RavuAlHemio/dcf77-faker/board/dcf77_faker.kicad_pcb

## KiCad design board/dcf77_faker.kicad_pcb (2023-04-06)

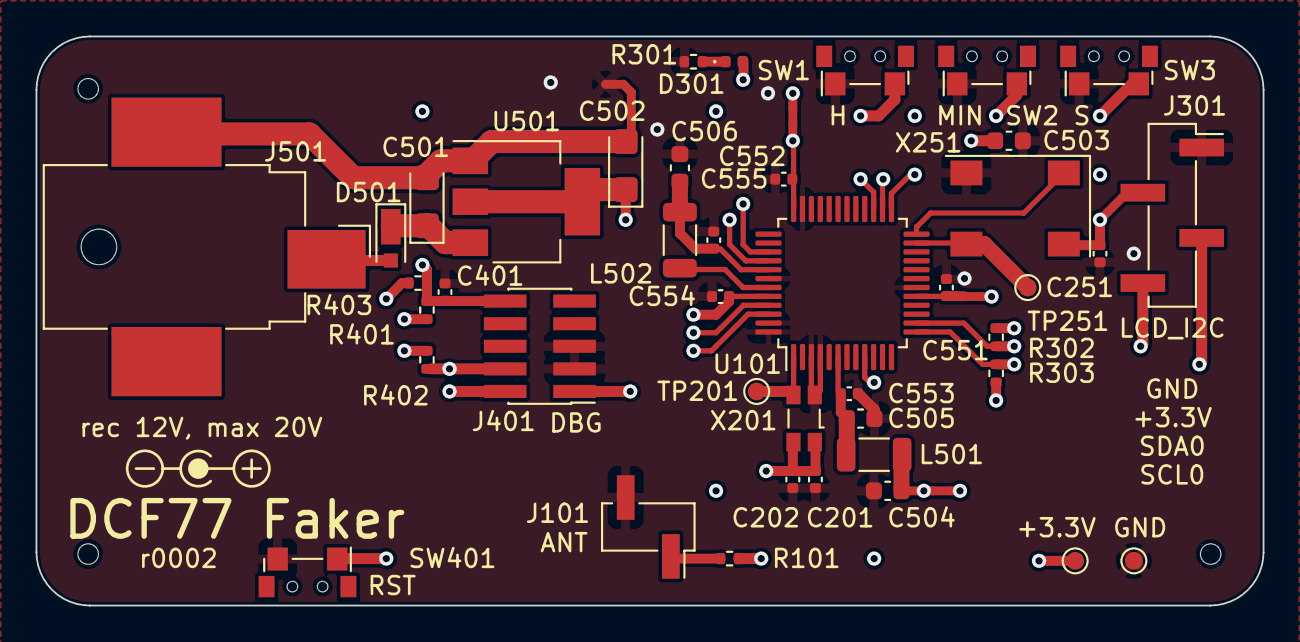
[picture p1: board dcf77_faker.kicad_pcb from above]

Board: 4 copper layers, 69.0 x 32.0 mm, 46 parts (0 on the bottom side), 27 nets.

Parts:
C201, C202, C251, C401, C551, C552, C553, C554, C555: 100nF; C_0402_1005Metric
C501, C502: 10µF; CP_EIA-3216-18_Kemet-A
C503, C504, C505: 10µF; C_0603_1608Metric
C506: 1µF; C_0603_1608Metric
D301: LED; LED_0402_1005Metric
D501: MSS1P3L-M3/89A; D_MicroSMP_AK
J101: ANT; PinHeader_1x02_P2.54mm_Vertical_SMD_Pin1Right
J301: LCD_I2C; PinHeader_1x04_P2.54mm_Vertical_SMD_Pin1Right
J401: DBG; PinHeader_2x05_P1.27mm_Vertical_SMD
J501: Barrel_Jack; BarrelJack_CUI_PJ-036AH-SMT_Horizontal
L501, L502: 10µH; L_1206_3216Metric
NT501, NT502, NT503, NT504: NetTie_2; NetTie-2_SMD_Pad0.5mm
R101, R402: 1kΩ; R_0402_1005Metric
R301, R401: 330Ω; R_0402_1005Metric
R302, R303: 1.5kΩ; R_0402_1005Metric
R403: 2.2kΩ; R_0402_1005Metric
SW1: H; Shou_Han_TS24CA
SW2: MIN; Shou_Han_TS24CA
SW3: S; Shou_Han_TS24CA
SW401: RST; Shou_Han_TS24CA
TP201, TP251, TP501, TP502: TestPoint; TestPoint_Pad_D1.0mm
U101: ATSAML21G18B-AUT; TQFP-48_7x7mm_P0.5mm
U501: NCP1117ST33T3G; SOT-223-3_TabPin2
X201: 32.768kHz; Oscillator_SMD_SeikoEpson_SG3030CM
X251: 31MHz; Oscillator_SMD_Microchip_DSC8001A-6Pin_7.0x5.0mm_HandSolder

Connections:
/+3.3V: C201.2, C202.2, C251.2, C502.1, J301.2, J401.1, NT502.2, NT504.2, R302.1, R303.1, R402.2, R403.2, TP501.1, U501.2 (VO), X201.1 (VIO), X201.4 (Vcc), X251.4 (Vcc)
/GND: C201.1, C202.1, C251.1, C401.1, C503.2, C504.2, C505.2, C506.2, C551.2, C552.2, C553.2, C554.2, C555.2, J101.2, J301.1, J401.3, J401.5, NT501.2, R301.1, SW1.1, SW2.1, SW3.1, SW401.2, TP502.1, U101.3 (PA02), U101.4 (PA03), U101.18 (GND), U101.35 (GND), U101.42 (GND), U101.47 (PB02), U101.48 (PB03), X201.2 (GND), X251.2 (GND)
/H: SW1.2, U101.27 (PA18)
/LED: D301.2 (A), U101.39 (PA27)
/MIN: SW2.2, U101.26 (PA17)
/S: SW3.2, U101.25 (PA16)
/SCL0: J301.4, R302.2, U101.14 (PA09)
/SDA0: J301.3, R303.2, U101.13 (PA08)
/TCC0WO0: R101.2, U101.9 (PA04)
/VDDANA: C505.1, C553.1, L501.2, U101.6 (VDDANA)
/VDDCORE: C506.1, C555.1, L502.1, U101.41 (VDDCORE)
/VDDIN: C504.1, C554.1, L501.1, NT504.1, U101.44 (VDDIN)
/VDDIO1: C551.1, NT503.2, U101.17 (VDDIO1)
/VDDIO2: C503.1, C552.1, NT502.1, NT503.1, U101.36 (VDDIO2)
/VSW: L502.2, U101.43 (VSW)
/XIN: TP251.1, U101.23 (PA14), X251.3 (OUT)
/XIN32: TP201.1, U101.1 (PA00), X201.3 (OUT)
/X~ST: U101.24 (PA15), X251.1 (~ST)
/debug & reset/SWCLK: J401.4, R402.1, U101.45 (PA30)
/debug & reset/SWDIO: J401.2, U101.46 (PA31)
/debug & reset/~RST: C401.2, J401.10, R401.1, R403.1, U101.40 (~RESET)
/power supply/RAWGND: C501.2, C502.2, J501.2, NT501.1, U501.1 (GND)
unnamed: D301.1 (K), R301.2
unnamed: D501.2 (A), J501.1
unnamed: C501.1, D501.1 (K), U501.3 (VI)
unnamed: J101.1, R101.1
unnamed: R401.2, SW401.1
