RavuAlHemio/dcf77-faker/(commit log)

2022-12-17 initial commit of current board status
    [dcf77_faker.kicad_pcb, dcf77_faker.kicad_sch]
2022-12-17 board: align schematic to grid
    [dcf77_faker.kicad_pcb, dcf77_faker.kicad_sch]
2022-12-17 board: add buttons to set hour/minute or reset second
    [dcf77_faker.kicad_pcb, dcf77_faker.kicad_sch]
2022-12-19 board: reorder HMS button pins
    this increases planarity of the PCB tracks
    [dcf77_faker.kicad_pcb, dcf77_faker.kicad_sch]
2022-12-19 board: remove PRL file
    it only contains project data relevant to the local machine
2022-12-19 board: force VDDIO1 and VDDIO2 to be independent nets
    otherwise the name of the common net will keep changing
    [dcf77_faker.kicad_pcb, dcf77_faker.kicad_sch]
2022-12-19 board: cleanup of odds and ends
    more spacing in the schematic, better pours on the PCB
    [dcf77_faker.kicad_pcb, dcf77_faker.kicad_sch]
2022-12-19 code: initial pin setup
2022-12-20 code: initial work on I2C controller logic
2022-12-20 code: rework I2C error structures
    [i2c_controller.rs]
2022-12-20 code: add I2C receive code
2022-12-20 code: i2c: also enable clocks
2022-12-20 code: add PWM code using TCC
2022-12-21 code: pwm: fix comment links
    [pwm.rs]
2022-12-21 code: add I2C LCD code
2023-01-09 board: fix button LCSC number
    we still had the flat ones
    [dcf77_faker.kicad_sch]
2023-01-09 board: slight PCB tweaks, more info
    [dcf77_faker.kicad_pcb]
2023-01-10 board: replace X2 with 7x5mm footprint (Microchip DSC8001A)
    this should make it easier to hand-solder after programming
    [dcf77_faker.kicad_pcb, dcf77_faker.kicad_sch]
2023-01-10 board: exclude net ties (do not actually exist) and X2 (DNP) from BOM
    [dcf77_faker.kicad_pcb]
2023-04-02 update some files to KiCad 7
    [dcf77_faker.kicad_pcb, dcf77_faker.kicad_sch]
2023-04-02 hand-solder X2, fix newly-detected DRC violations
    [dcf77_faker.kicad_pcb, dcf77_faker.kicad_sch]
2023-04-06 board: allow disabling X2
    [dcf77_faker.kicad_pcb, dcf77_faker.kicad_sch]
2023-04-06 board: move RST to make space for battery input
    [dcf77_faker.kicad_pcb, dcf77_faker.kicad_sch]
2023-04-06 board: extend lines in power supply box to create rectangle
    [dcf77_faker.kicad_sch]
2023-04-06 board: hierarchical sheets, renumber components
    [dcf77_faker.kicad_pcb, dcf77_faker.kicad_sch, debug_reset.kicad_sch, lcd_buttons_led.kicad_sch, oscillators.kicad_sch, power_supply.kicad_sch]
